SHR-sky/2023-H/(threads)

Thread 1 (2024-07-16):

关于DAC输出的问题

chen03, 2024-07-16:
无论输入ADC的信号是多大，DAC信号输出频率不变。并且其输出波形既不像三角波也不像正弦波
![Uploading 111.jpg…]()

SHR-sky, 2024-07-16:
建议用串口输出fre[1]和fre[0]，观察是否成功解算出两个输入信号的频率

SHR-sky, 2024-07-19:
并且本方案DA输出波形采用的是查表法，在FFT没有爆栈的情况下，输出的波形一定会使标准的波形。建议检查移植过程中，DMA配置是否成功。

chen03, 2024-07-19:
好的谢谢您，我再检查一下。

---原始邮件---
发件人: ***@***.***&gt;
发送时间: 2024年7月19日(周五) 下午3:55
收件人: ***@***.***&gt;;
抄送: ***@***.******@***.***&gt;;
主题: Re: [SHR-sky/2023-H] 关于DAC输出的问题 (Issue #1)

并且本方案DA输出波形采用的是查表法，在FFT没有爆栈的情况下，输出的波形一定会使标准的波形。建议检查移植过程中，DMA配置是否成功。

—
Reply to this email directly, view it on GitHub, or unsubscribe.
You are receiving this because you authored the thread.Message ID: ***@***.***&gt;

Closed 2024-07-19.

Thread 2 (2024-07-19):

信号频率的问题

runaway19, 2024-07-19:
为什么我测到的频率飘忽不定，我是直接把fre这个数组的值显示出来，频率用的是5k的倍数

SHR-sky, 2024-07-19:
要保证前端加法器输出的混合波形稳定。并且，main函数中只会测量一次频率，测定后不会再改变，“飘忽不定”是指每次reset后，显示的频率都不一样吗？

runaway19, 2024-07-19:
是的

SHR-sky, 2024-07-19:
建议首先检测加法器输出波形的稳定。如果没有问题，建议直接用DA将AD采到的波形直接重建，观察是否成功采样。

runaway19, 2024-07-19:
如果我直接用示波器输入信号，那这种方法能不能将两个信号的频率分出来，如果不能，那我只是想将重叠信号的频率分出来，那要用什么方法

SHR-sky, 2024-07-19:
首先，该方案前端需要加法器电路混合从信号发生器而来的信号，再输入混合信号到AD，不存在直接输入信号到AD。其次，关于“重叠信号频率”的问题，建议首先翻阅报告、查阅原理，以及了解频谱分析、数字正交分解的相关知识。

runaway19, 2024-07-19:
好的，谢了

Closed 2024-07-19.
