SHR-sky/2023-H/H/Hardware/TIM.c

// TIM4
#include "TIM.h"

#define ARR_NUM 10000
#define PSC_NUM 84

void Timer_Init(void)
{

	// Input Capture
	// PB6 ~PB9 -> TIM4CH1~CH4
	GPIO_InitTypeDef GPIO_InitStructure;
	RCC_AHB1PeriphClockCmd(RCC_AHB1Periph_GPIOB, ENABLE);
	GPIO_InitStructure.GPIO_PuPd = GPIO_PuPd_NOPULL;
	GPIO_PinAFConfig(GPIOB, GPIO_PinSource6, GPIO_AF_TIM4);
	GPIO_PinAFConfig(GPIOB, GPIO_PinSource7, GPIO_AF_TIM4);
	GPIO_PinAFConfig(GPIOB, GPIO_PinSource8, GPIO_AF_TIM4);
	GPIO_PinAFConfig(GPIOB, GPIO_PinSource9, GPIO_AF_TIM4);
	GPIO_InitStructure.GPIO_Mode = GPIO_Mode_AF;
	GPIO_InitStructure.GPIO_Pin = GPIO_Pin_6 | GPIO_Pin_7 | GPIO_Pin_8 | GPIO_Pin_9;
	GPIO_Init(GPIOB, &GPIO_InitStructure);


	RCC_APB1PeriphClockCmd(RCC_APB1Periph_TIM2, ENABLE); // 开启时钟

	TIM_InternalClockConfig(TIM2);

	TIM_TimeBaseInitTypeDef TIM_TimeBaseInitStructure; // TIM结构体
	TIM_TimeBaseInitStructure.TIM_ClockDivision = TIM_CKD_DIV1;
	TIM_TimeBaseInitStructure.TIM_CounterMode = TIM_CounterMode_Up;
	TIM_TimeBaseInitStructure.TIM_Period = ARR_NUM - 1;
	TIM_TimeBaseInitStructure.TIM_Prescaler = PSC_NUM - 1;
	TIM_TimeBaseInitStructure.TIM_RepetitionCounter = 0;
	TIM_TimeBaseInit(TIM2, &TIM_TimeBaseInitStructure);

	TIM_ClearFlag(TIM2, TIM_FLAG_Update); // 清除更新时的中断标志位，防止更新时程序直接进入中断
	TIM_ITConfig(TIM2, TIM_IT_Update, ENABLE);

	NVIC_PriorityGroupConfig(NVIC_PriorityGroup_2);

	NVIC_InitTypeDef NVIC_InitStructure; // NVIC结构体
	NVIC_InitStructure.NVIC_IRQChannel = TIM2_IRQn;
	NVIC_InitStructure.NVIC_IRQChannelCmd = ENABLE;
	NVIC_InitStructure.NVIC_IRQChannelPreemptionPriority = 2; // 优先级
	NVIC_InitStructure.NVIC_IRQChannelSubPriority = 1;		  // 相应优先级
	NVIC_Init(&NVIC_InitStructure);

	TIM_Cmd(TIM2, ENABLE);
}
