SHR-sky/2023-H/(commit log)

2024-07-13 去除无用代码
2024-07-16 注释及报告修改
2026-08-15 完善项目文档并添加查表生成脚本
